Tristan-Technologies/EASem2Help/README.md

# EASem2Help
Project repository for Singapore Polytechnic Engineering Academy Academic Year 2019/2020 Semester 2 tracked vehicle project
