Tristan-Technologies/EASem2Help/Interface.md

# Interface  :bookmark_tabs:
Shows how the wires are connected inside.
Help to track down connections if there is a problem with the wiring.
<details>
<summary>Interface </summary>
<ul>
<li>

  [Pin Configuration]()

<li>

  [ Color Code]()

  </li>
  <ul>

  <li></il>
  <li></il>
  <li></il>

</ul>
<li>

[Schematic Drawing]()
</ul>
