Tristan-Technologies/EASem2Help/ESP_32/Pin_Configuration/Pictures/esp32_pinout_custom.jpg

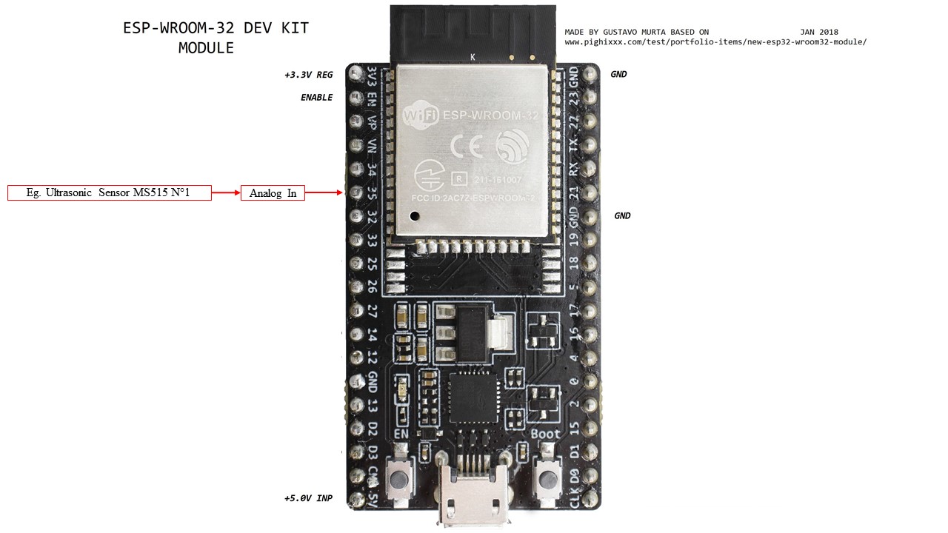
ESP_32/Pin_Configuration/Pictures/esp32_pinout_custom.jpg
