Tristan-Technologies/EASem2Help/Electrical_Components/boost_converter_cir.png

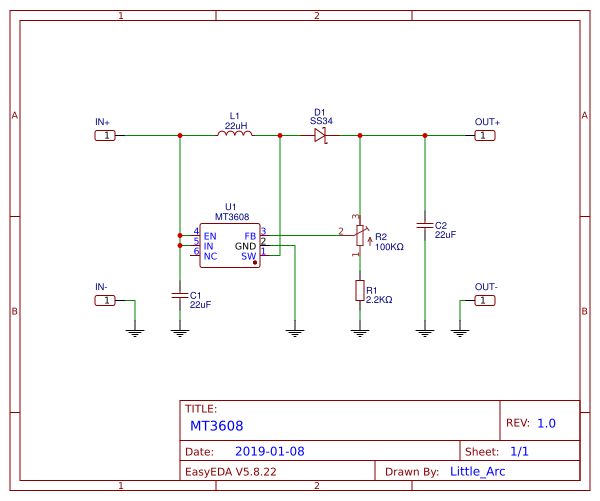
Electrical_Components/boost_converter_cir.png
