Tristan-Technologies/EASem2Help/Electrical_Components/ln298n.png

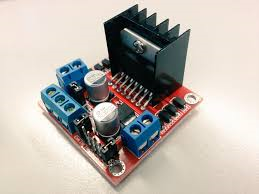
Electrical_Components/ln298n.png
