Tristan-Technologies/EASem2Help/Electrical_Components/power2.png

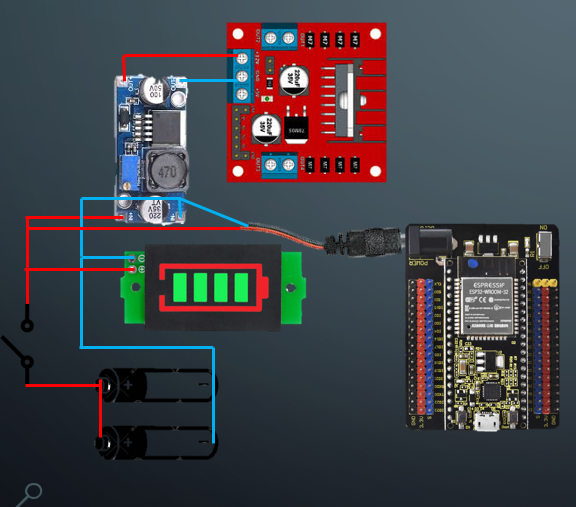
Electrical_Components/power2.png
