Tristan-Technologies/EASem2Help/Mechanical_Components/Pictures/Interpolation.png

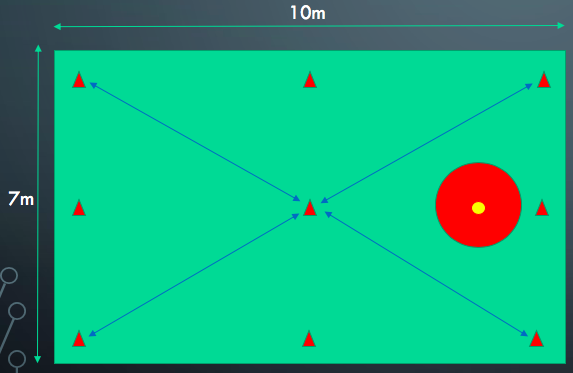
Mechanical_Components/Pictures/Interpolation.png
