Tristan-Technologies/EASem2Help/Model_Tank_Assembly_Review/Images/3.3.png

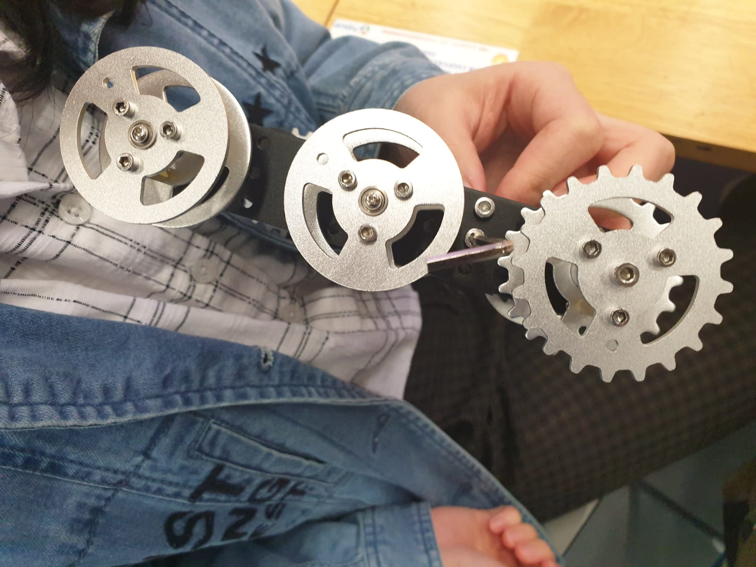
Model_Tank_Assembly_Review/Images/3.3.png
