Tristan-Technologies/EASem2Help/Model_Tank_Assembly_Review/Images/3.5.png

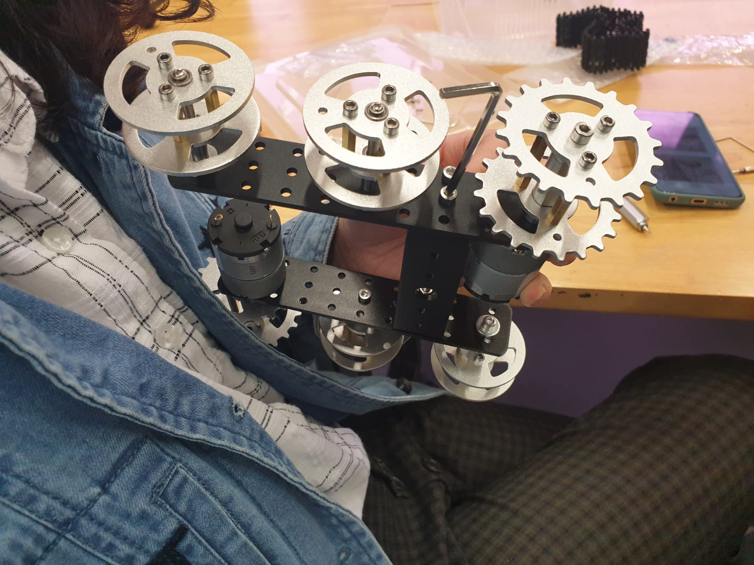
Model_Tank_Assembly_Review/Images/3.5.png
