Tristan-Technologies/EASem2Help/Model_Tank_Assembly_Review/Images/6.png

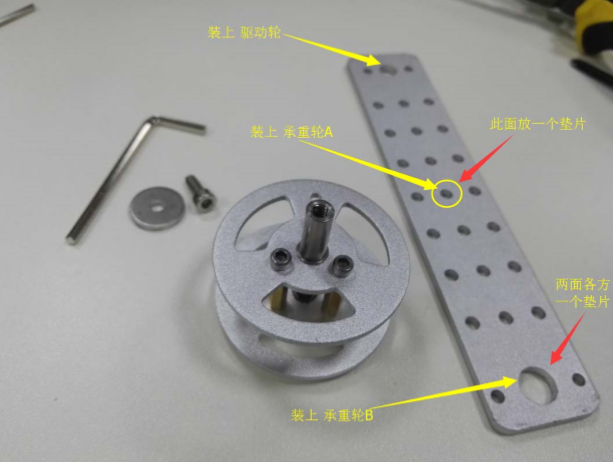
Model_Tank_Assembly_Review/Images/6.png
