Tristan-Technologies/EASem2Help/Model_Tank_Assembly_Review/Images/20191030_115636.jpg

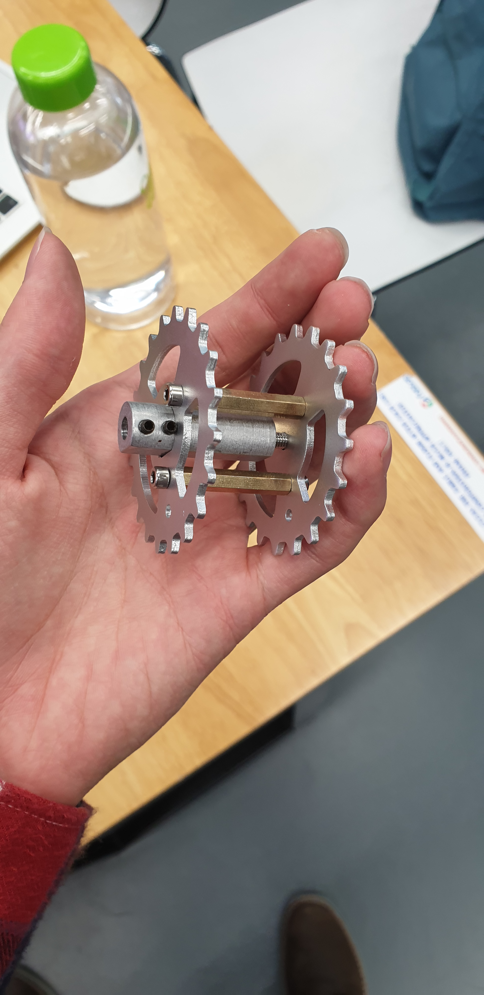
Model_Tank_Assembly_Review/Images/20191030_115636.jpg
