Tristan-Technologies/EASem2Help/Model_Tank_Assembly_Review/Images/20191030_115642.jpg

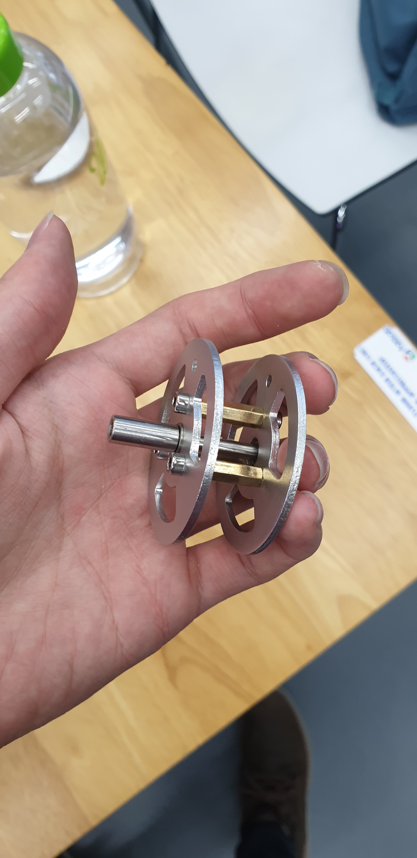
Model_Tank_Assembly_Review/Images/20191030_115642.jpg
