Tristan-Technologies/EASem2Help/(commit log)

2019-10-30 Added files for chassis assembly documentation
    does coffee liquor make you sleepy or keep you awake?
2019-11-09 Added ESP32 Setup
2019-11-13 Updates
    Streamlined files and added new landing pages
2019-12-14 Added Pin Config
    Updates will be made to project pin config as it is developed
2020-02-18 Create Motor Calculations.md
2020-02-18 Update Camera Gimbal.md
2020-02-18 Update Motor Calculations.md
2020-02-21 Create Torque Formula.PNG
2020-02-21 Update Max. Tractive torque graph.png
